sivansha/Arduino-strainGauge/README.md

# Arduino Strain gauge
Arduino + strain gauge for sensitive stress detection<br>

The Project have been used for "hands on wheel" detection for car simulator, but can be used in general for sensitive stress detection using Arduino and communicating over CAN bus.<br>
For full details, see the attached paper.

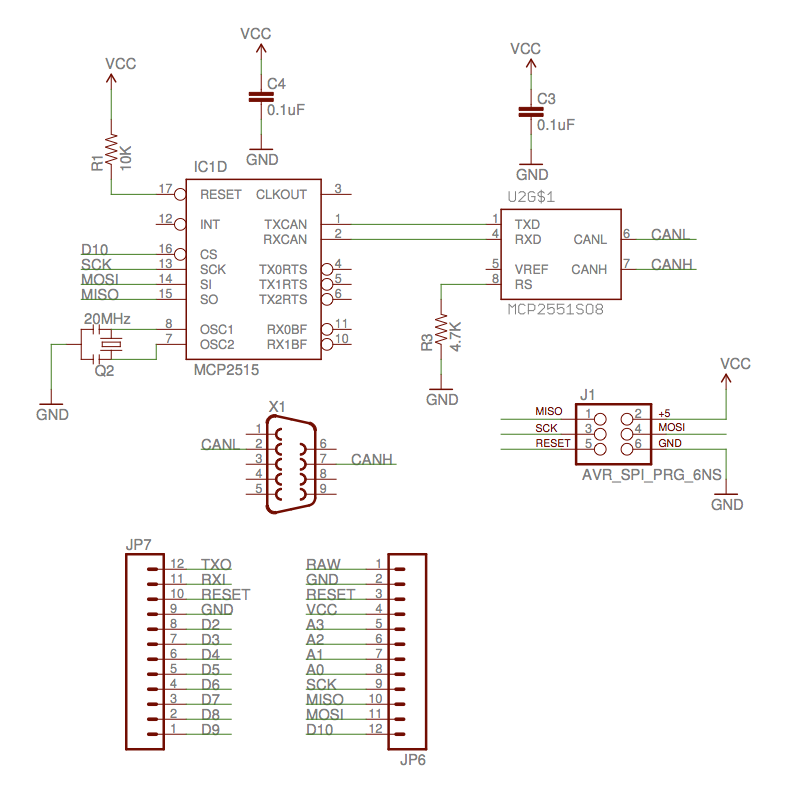
[picture p1: CANShield.png]
Can Shiled

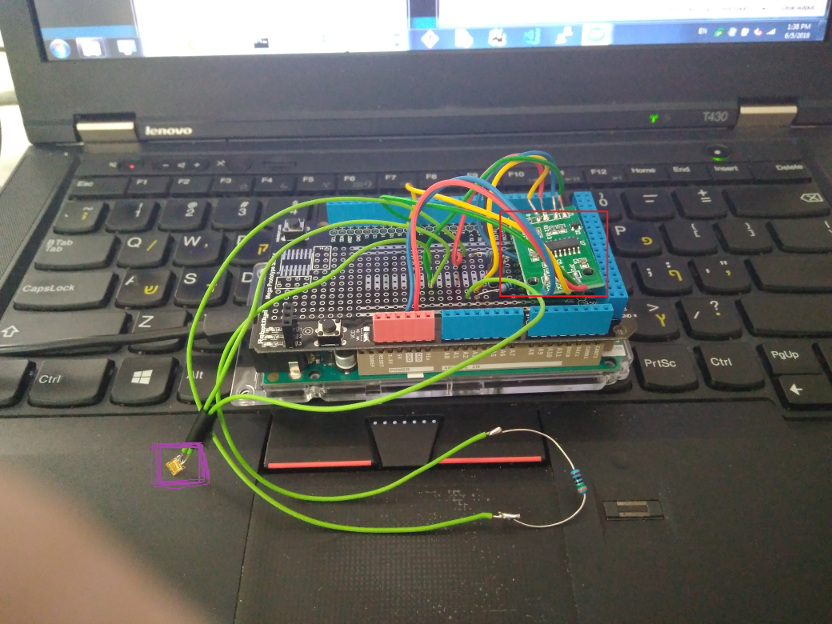
[picture p2: Arduino-parts.jpg]
Arduino board
